aaron-clovsky/hdmi_switch_cond_pwr/hdmi_switch_cond_pwr.asc

D1: diode; 1N4148
D2: diode; 1N4148
D3: diode; 1N4148
HDMI_OUT: res; 10
LED_DRV_1: voltage; 5
LED_DRV_2: voltage; 5
LED_DRV_3: voltage; 5
PSU: voltage; 5
Q1: npn; 2N2222
Q2: pnp; BC327-25
R1: res; 100K
R2: res; 1K
Named nets: 0
.tran 0 30 1 0.001
